DamianBaranski/miniEFIS/models/sztuczny_horyzont_model-Body.stl

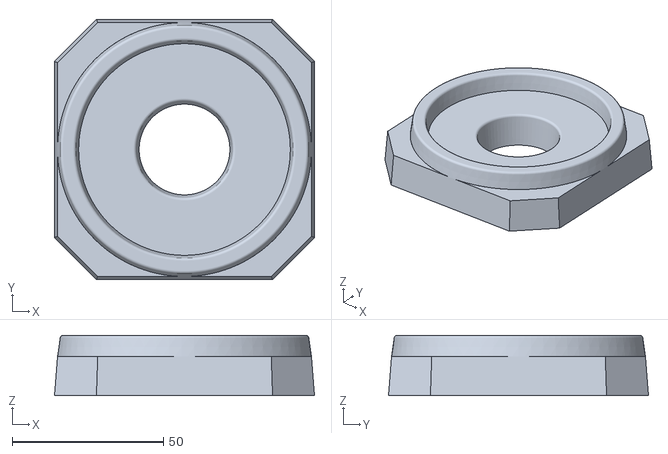
[picture p1: CAD file, 2026-10-16]
models/sztuczny_horyzont_model-Body.stl
86.0 x 86.0 x 20.0
