DamianBaranski/miniEFIS/(list of files, cad)

Other CAD files:
sztuczny_horyzont_model.FCStd
