DamianBaranski/miniEFIS/(commit log)

2026-10-16 Initial miniEFIS firmware: remove dead mag calibration path, unused files and LVGL extras
    [partitions.csv, sztuczny_horyzont_model-Body.stl, sztuczny_horyzont_model.FCStd]
2026-10-16 Swipe left/right to switch between instrument screens
2026-10-16 Add Set level mounting alignment and heap corruption instrumentation
2026-10-17 Add CAN bus receiver on GPIO19/20, protocol doc, debug page section and GPS emulator
2026-10-18 CAN: driver error counters and RX level on debug page, endpoint docs, emulator fixes for USB-CAN Analyzer
    [can_bus.cpp, can_bus.h, gps_emulator.py, wifi_debug.cpp]
2026-10-18 Engine and cylinders screens with swipe-down display menu, EMU emulator, custom engine limits, settings sub-pages, diagnostics screen removed, touch injection endpoint
